OGggggish/tt-ota-sky130/sim/tb_pex_ffm40.spice

* tb_pex_ffm40 - loop gain, C-extracted DUT, ff -40C, 100u/100p
.lib /foss/pdks/sky130A/libs.tech/ngspice/sky130.lib.spice ff
.include /foss/designs/ldo_project/layout/ldo_pex_brk.spice

Vdd  vdd 0 1.8
Ib   vdd vbias 10u
Vref vref 0 0.9
Vlen load_en 0 0
X1 vref vbias vldo load_en vdd 0 fbtop_x ldo_pex_brk
CL  vldo 0 100p
IL  vldo 0 100u
L3  vldo fbtop_x 1G
Cinj fbtop_x nin 1G
Vin nin 0 0 ac 1

.nodeset v(vldo)=1.5 v(fbtop_x)=1.5
.option rshunt=1e12
.temp -40
.op
.ac dec 20 1 1G

.control
run
setplot ac1
let t    = v(vldo)/v(fbtop_x)
let t_db = db(t)
let t_ph = 180/pi*cph(t)
meas ac t0    find t_db at=1
meas ac fu    when t_db=0 cross=1
meas ac ph_fu find t_ph when t_db=0 cross=1
meas ac floor find t_db at=800meg
set hcopydevtype=svg
set color0=white
set color1=black
set svg_intopts = ( 1024 768 18 0 1 2 0 )
hardcopy bode_pex_ffm40_100u.svg t_db t_ph xlimit 1 100meg ylimit -200 200
.endc
.end
