OGggggish/tt-ota-sky130/sim/ldo_pex_brk.spice

.subckt ldo_pex_brk ua[0] ua[1] ua[2] ui_in[0] VDPWR VGND fbtop_x
* NGSPICE file created from tt_um_ogggggish_ota_ldo.ext - technology: sky130A

X0 ldo_chip_0/Msw/D4 ua[2] VGND sky130_fd_pr__res_high_po_1p41 l=1.36
X1 ldo_chip_0/Msw/D4 ui_in[0] VGND VGND sky130_fd_pr__nfet_01v8 ad=0.725 pd=5.29 as=0.725 ps=5.29 w=5 l=0.5
X2 VGND ui_in[0] ldo_chip_0/Msw/D4 VGND sky130_fd_pr__nfet_01v8 ad=0.725 pd=5.29 as=0.725 ps=5.29 w=5 l=0.5
X3 VGND ui_in[0] ldo_chip_0/Msw/D4 VGND sky130_fd_pr__nfet_01v8 ad=0.725 pd=5.29 as=1.45 ps=10.58 w=5 l=0.5
X4 ldo_chip_0/Msw/D4 ui_in[0] VGND VGND sky130_fd_pr__nfet_01v8 ad=0.725 pd=5.29 as=0.725 ps=5.29 w=5 l=0.5
X5 ldo_chip_0/Msw/D4 ui_in[0] VGND VGND sky130_fd_pr__nfet_01v8 ad=1.45 pd=10.58 as=0.725 ps=5.29 w=5 l=0.5
X6 VGND ui_in[0] ldo_chip_0/Msw/D4 VGND sky130_fd_pr__nfet_01v8 ad=0.725 pd=5.29 as=0.725 ps=5.29 w=5 l=0.5
X7 ldo_chip_0/M4/G ua[0] ldo_chip_0/M5/D VGND sky130_fd_pr__nfet_01v8 ad=1.45 pd=10.58 as=0.725 ps=5.29 w=5 l=0.5
X8 ldo_chip_0/M5/D ua[0] ldo_chip_0/M4/G VGND sky130_fd_pr__nfet_01v8 ad=0.725 pd=5.29 as=1.45 ps=10.58 w=5 l=0.5
X9 ldo_chip_0/RZ/R1 ldo_chip_0/RZ/R2 VGND sky130_fd_pr__res_high_po_0p69 l=1.2
X10 ldo_chip_0/M4/D ldo_chip_0/M2/G1 ldo_chip_0/M5/D VGND sky130_fd_pr__nfet_01v8 ad=2.9 pd=21.16 as=4.35 ps=31.74 w=5 l=0.5
X11 ldo_chip_0/M5/D ldo_chip_0/M2/G1 ldo_chip_0/M4/D VGND sky130_fd_pr__nfet_01v8 ad=0 pd=0 as=0 ps=0 w=5 l=0.5
X12 VDPWR ldo_chip_0/M4/G ldo_chip_0/M4/G VDPWR sky130_fd_pr__pfet_01v8 ad=1.45 pd=10.58 as=1.45 ps=10.58 w=5 l=0.5
X13 VDPWR ldo_chip_0/M4/G ldo_chip_0/M4/D VDPWR sky130_fd_pr__pfet_01v8 ad=382.20001 pd=2.51288k as=1.45 ps=10.58 w=5 l=0.5
X14 VGND ua[1] ldo_chip_0/M5/D VGND sky130_fd_pr__nfet_01v8 ad=1.45 pd=10.58 as=1.45 ps=10.58 w=5 l=1
X15 VGND ua[1] ua[1] VGND sky130_fd_pr__nfet_01v8 ad=29 pd=211.60001 as=1.45 ps=10.58 w=5 l=1
X16 ldo_chip_0/RZ/R2 ldo_chip_0/M4/D VDPWR VDPWR sky130_fd_pr__pfet_01v8 ad=0.725 pd=5.29 as=0.725 ps=5.29 w=5 l=0.5
X17 ldo_chip_0/RZ/R2 ldo_chip_0/M4/D VDPWR VDPWR sky130_fd_pr__pfet_01v8 ad=1.45 pd=10.58 as=0.725 ps=5.29 w=5 l=0.5
X18 VDPWR ldo_chip_0/M4/D ldo_chip_0/RZ/R2 VDPWR sky130_fd_pr__pfet_01v8 ad=0.725 pd=5.29 as=0.725 ps=5.29 w=5 l=0.5
X19 VDPWR ldo_chip_0/M4/D ldo_chip_0/RZ/R2 VDPWR sky130_fd_pr__pfet_01v8 ad=0.725 pd=5.29 as=0.725 ps=5.29 w=5 l=0.5
X20 ldo_chip_0/RZ/R2 ldo_chip_0/M4/D VDPWR VDPWR sky130_fd_pr__pfet_01v8 ad=0.725 pd=5.29 as=0.725 ps=5.29 w=5 l=0.5
X21 ldo_chip_0/RZ/R2 ldo_chip_0/M4/D VDPWR VDPWR sky130_fd_pr__pfet_01v8 ad=0.725 pd=5.29 as=0.725 ps=5.29 w=5 l=0.5
X22 VDPWR ldo_chip_0/M4/D ldo_chip_0/RZ/R2 VDPWR sky130_fd_pr__pfet_01v8 ad=0.725 pd=5.29 as=0.725 ps=5.29 w=5 l=0.5
X23 VDPWR ldo_chip_0/M4/D ldo_chip_0/RZ/R2 VDPWR sky130_fd_pr__pfet_01v8 ad=0.725 pd=5.29 as=0.725 ps=5.29 w=5 l=0.5
X24 VDPWR ldo_chip_0/M4/D ldo_chip_0/RZ/R2 VDPWR sky130_fd_pr__pfet_01v8 ad=0.725 pd=5.29 as=0.725 ps=5.29 w=5 l=0.5
X25 ldo_chip_0/RZ/R2 ldo_chip_0/M4/D VDPWR VDPWR sky130_fd_pr__pfet_01v8 ad=0.725 pd=5.29 as=0.725 ps=5.29 w=5 l=0.5
X26 ldo_chip_0/RZ/R2 ldo_chip_0/M4/D VDPWR VDPWR sky130_fd_pr__pfet_01v8 ad=0.725 pd=5.29 as=0.725 ps=5.29 w=5 l=0.5
X27 VDPWR ldo_chip_0/M4/D ldo_chip_0/RZ/R2 VDPWR sky130_fd_pr__pfet_01v8 ad=0.725 pd=5.29 as=1.45 ps=10.58 w=5 l=0.5
X28 VGND ua[1] ldo_chip_0/RZ/R2 VGND sky130_fd_pr__nfet_01v8 ad=0.725 pd=5.29 as=0.725 ps=5.29 w=5 l=1
X29 ldo_chip_0/RZ/R2 ua[1] VGND VGND sky130_fd_pr__nfet_01v8 ad=1.45 pd=10.58 as=0.725 ps=5.29 w=5 l=1
X30 VGND ua[1] ldo_chip_0/RZ/R2 VGND sky130_fd_pr__nfet_01v8 ad=0.725 pd=5.29 as=0.725 ps=5.29 w=5 l=1
X31 ldo_chip_0/RZ/R2 ua[1] VGND VGND sky130_fd_pr__nfet_01v8 ad=0.725 pd=5.29 as=0.725 ps=5.29 w=5 l=1
X32 VGND ua[1] ldo_chip_0/RZ/R2 VGND sky130_fd_pr__nfet_01v8 ad=0.725 pd=5.29 as=1.45 ps=10.58 w=5 l=1
X33 ldo_chip_0/RZ/R2 ua[1] VGND VGND sky130_fd_pr__nfet_01v8 ad=0.725 pd=5.29 as=0.725 ps=5.29 w=5 l=1
X34 VGND ua[2] VGND sky130_fd_pr__res_high_po_2p85 l=12.3
X35 ldo_chip_0/Mb1/B ldo_chip_0/RZ/R2 ldo_chip_0/Mb3/D ldo_chip_0/Mb1/B sky130_fd_pr__pfet_01v8_lvt ad=0.725 pd=5.29 as=1.45 ps=10.58 w=5 l=0.5
X36 ldo_chip_0/Mb3/D ldo_chip_0/RZ/R2 ldo_chip_0/Mb1/B ldo_chip_0/Mb1/B sky130_fd_pr__pfet_01v8_lvt ad=0.725 pd=5.29 as=0.725 ps=5.29 w=5 l=0.5
X37 ldo_chip_0/Mb3/D ldo_chip_0/RZ/R2 ldo_chip_0/Mb1/B ldo_chip_0/Mb1/B sky130_fd_pr__pfet_01v8_lvt ad=1.45 pd=10.58 as=0.725 ps=5.29 w=5 l=0.5
X38 ldo_chip_0/Mb1/B ldo_chip_0/RZ/R2 ldo_chip_0/Mb3/D ldo_chip_0/Mb1/B sky130_fd_pr__pfet_01v8_lvt ad=0.725 pd=5.29 as=0.725 ps=5.29 w=5 l=0.5
X39 ldo_chip_0/Mb1/B ldo_chip_0/RZ/R2 ldo_chip_0/Mb3/D ldo_chip_0/Mb1/B sky130_fd_pr__pfet_01v8_lvt ad=0.725 pd=5.29 as=0.725 ps=5.29 w=5 l=0.5
X40 ldo_chip_0/Mb3/D ldo_chip_0/RZ/R2 ldo_chip_0/Mb1/B ldo_chip_0/Mb1/B sky130_fd_pr__pfet_01v8_lvt ad=0.725 pd=5.29 as=0.725 ps=5.29 w=5 l=0.5
X41 ldo_chip_0/Mb3/D ldo_chip_0/RZ/R2 ldo_chip_0/Mb1/B ldo_chip_0/Mb1/B sky130_fd_pr__pfet_01v8_lvt ad=0.725 pd=5.29 as=0.725 ps=5.29 w=5 l=0.5
X42 ldo_chip_0/Mb3/D ldo_chip_0/RZ/R2 ldo_chip_0/Mb1/B ldo_chip_0/Mb1/B sky130_fd_pr__pfet_01v8_lvt ad=0.725 pd=5.29 as=0.725 ps=5.29 w=5 l=0.5
X43 ldo_chip_0/Mb1/B ldo_chip_0/RZ/R2 ldo_chip_0/Mb3/D ldo_chip_0/Mb1/B sky130_fd_pr__pfet_01v8_lvt ad=0.725 pd=5.29 as=0.725 ps=5.29 w=5 l=0.5
X44 ldo_chip_0/Mb1/B ldo_chip_0/RZ/R2 ldo_chip_0/Mb3/D ldo_chip_0/Mb1/B sky130_fd_pr__pfet_01v8_lvt ad=0.725 pd=5.29 as=0.725 ps=5.29 w=5 l=0.5
X45 VGND ldo_chip_0/Mb3/D ldo_chip_0/Mb1/B VGND sky130_fd_pr__nfet_01v8 ad=0.725 pd=5.29 as=0.725 ps=5.29 w=5 l=0.5
X46 ldo_chip_0/Mb1/B ldo_chip_0/Mb3/D VGND VGND sky130_fd_pr__nfet_01v8 ad=0.725 pd=5.29 as=0.725 ps=5.29 w=5 l=0.5
X47 ldo_chip_0/Mb1/B ldo_chip_0/Mb3/D VGND VGND sky130_fd_pr__nfet_01v8 ad=0.725 pd=5.29 as=0.725 ps=5.29 w=5 l=0.5
X48 VGND ldo_chip_0/Mb3/D ldo_chip_0/Mb1/B VGND sky130_fd_pr__nfet_01v8 ad=0.725 pd=5.29 as=0.725 ps=5.29 w=5 l=0.5
X49 VGND ldo_chip_0/Mb3/D ldo_chip_0/Mb1/B VGND sky130_fd_pr__nfet_01v8 ad=0.725 pd=5.29 as=0.725 ps=5.29 w=5 l=0.5
X50 ldo_chip_0/Mb1/B ldo_chip_0/Mb3/D VGND VGND sky130_fd_pr__nfet_01v8 ad=0.725 pd=5.29 as=0.725 ps=5.29 w=5 l=0.5
X51 ldo_chip_0/Mb1/B ldo_chip_0/Mb3/D VGND VGND sky130_fd_pr__nfet_01v8 ad=0.725 pd=5.29 as=0.725 ps=5.29 w=5 l=0.5
X52 VGND ldo_chip_0/Mb3/D ldo_chip_0/Mb1/B VGND sky130_fd_pr__nfet_01v8 ad=0.725 pd=5.29 as=0.725 ps=5.29 w=5 l=0.5
X53 ldo_chip_0/Mb1/B ldo_chip_0/Mb3/D VGND VGND sky130_fd_pr__nfet_01v8 ad=0.725 pd=5.29 as=0.725 ps=5.29 w=5 l=0.5
X54 VGND ldo_chip_0/Mb3/D ldo_chip_0/Mb1/B VGND sky130_fd_pr__nfet_01v8 ad=0.725 pd=5.29 as=0.725 ps=5.29 w=5 l=0.5
X55 VGND ldo_chip_0/Mb3/D ldo_chip_0/Mb1/B VGND sky130_fd_pr__nfet_01v8 ad=0.725 pd=5.29 as=0.725 ps=5.29 w=5 l=0.5
X56 VGND ldo_chip_0/Mb3/D ldo_chip_0/Mb1/B VGND sky130_fd_pr__nfet_01v8 ad=0.725 pd=5.29 as=1.45 ps=10.58 w=5 l=0.5
X57 ldo_chip_0/Mb1/B ldo_chip_0/Mb3/D VGND VGND sky130_fd_pr__nfet_01v8 ad=1.45 pd=10.58 as=0.725 ps=5.29 w=5 l=0.5
X58 ldo_chip_0/Mb1/B ldo_chip_0/Mb3/D VGND VGND sky130_fd_pr__nfet_01v8 ad=0.725 pd=5.29 as=0.725 ps=5.29 w=5 l=0.5
X59 VGND ldo_chip_0/Mb3/D ldo_chip_0/Mb1/B VGND sky130_fd_pr__nfet_01v8 ad=0.725 pd=5.29 as=0.725 ps=5.29 w=5 l=0.5
X60 VGND ldo_chip_0/Mb3/D ldo_chip_0/Mb1/B VGND sky130_fd_pr__nfet_01v8 ad=0.725 pd=5.29 as=0.725 ps=5.29 w=5 l=0.5
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
X265 VDPWR ldo_chip_0/Mb1/B ua[2] VDPWR sky130_fd_pr__pfet_01v8 ad=0.825 pd=5.33 as=0.825 ps=5.33 w=5 l=0.15
X266 ua[2] ldo_chip_0/Mb1/B VDPWR VDPWR sky130_fd_pr__pfet_01v8 ad=0.825 pd=5.33 as=0.825 ps=5.33 w=5 l=0.15
X267 ua[2] ldo_chip_0/Mb1/B VDPWR VDPWR sky130_fd_pr__pfet_01v8 ad=0.825 pd=5.33 as=0.825 ps=5.33 w=5 l=0.15
X268 ua[2] ldo_chip_0/Mb1/B VDPWR VDPWR sky130_fd_pr__pfet_01v8 ad=1.55 pd=10.62 as=0.825 ps=5.33 w=5 l=0.15
X269 ua[2] ldo_chip_0/Mb1/B VDPWR VDPWR sky130_fd_pr__pfet_01v8 ad=0.825 pd=5.33 as=0.825 ps=5.33 w=5 l=0.15
X270 ua[2] ldo_chip_0/Mb1/B VDPWR VDPWR sky130_fd_pr__pfet_01v8 ad=0.825 pd=5.33 as=0.825 ps=5.33 w=5 l=0.15
X271 VDPWR ldo_chip_0/Mb1/B ua[2] VDPWR sky130_fd_pr__pfet_01v8 ad=0.825 pd=5.33 as=0.825 ps=5.33 w=5 l=0.15
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
