OGggggish/tt-ota-sky130/sim/tb_ref_ss125.spice

* tb_ref_tt - loop gain, schematic DUT, tt, 100u/100p
.lib /foss/pdks/sky130A/libs.tech/ngspice/sky130.lib.spice ss
.include /foss/designs/ldo_project/ldo_chip_brk.spice

Vdd  vdd 0 1.8
Ib   vdd vbias 10u
Vref vref 0 0.9
Vlen load_en 0 0
X1 vdd vbias vref vldo load_en 0 fbtop_x ldo_chip_brk
CL  vldo 0 100p
IL  vldo 0 100u
L3  vldo fbtop_x 1G
Cinj fbtop_x nin 1G
Vin nin 0 0 ac 1

.nodeset v(vldo)=1.5 v(fbtop_x)=1.5 v(x1.vfb)=0.9 v(x1.vout1)=0.70 v(x1.vout2)=0.66 v(x1.vgate)=1.06 v(x1.nx)=0.68
.temp 125
.op
.ac dec 20 1 1G

.control
run
setplot ac1
let t    = v(vldo)/v(fbtop_x)
let t_db = db(t)
let t_ph = 180/pi*cph(t)
meas ac t0    find t_db at=1
meas ac fu    when t_db=0 cross=1
meas ac ph_fu find t_ph when t_db=0 cross=1
meas ac floor find t_db at=800meg
set hcopydevtype=svg
hardcopy bode_ref_ss125_100u.svg t_db t_ph
.endc
.end
