OGggggish/tt-ota-sky130/lvs/tt_um_ogggggish_ota_ldo_lvs.spice

* NGSPICE file created from tt_um_ogggggish_ota_ldo.ext - technology: sky130A

.subckt sky130_fd_pr__res_high_po_1p41_SX68GJ R1 R2 VSUBS
X0 R1 R2 VSUBS sky130_fd_pr__res_high_po_1p41 l=1.36
.ends

.subckt sky130_fd_pr__nfet_01v8_QDCVMV B D0 G0 S1 G1 D2 G2 S3 G3 D4 G4 S5 G5 a_445_n500#
X0 D2 G1 S1 B sky130_fd_pr__nfet_01v8 ad=0.725 pd=5.29 as=0.725 ps=5.29 w=5 l=0.5
X1 S5 G4 D4 B sky130_fd_pr__nfet_01v8 ad=0.725 pd=5.29 as=0.725 ps=5.29 w=5 l=0.5
X2 S1 G0 D0 B sky130_fd_pr__nfet_01v8 ad=0.725 pd=5.29 as=1.45 ps=10.58 w=5 l=0.5
X3 D4 G3 S3 B sky130_fd_pr__nfet_01v8 ad=0.725 pd=5.29 as=0.725 ps=5.29 w=5 l=0.5
X4 a_445_n500# G5 S5 B sky130_fd_pr__nfet_01v8 ad=1.45 pd=10.58 as=0.725 ps=5.29 w=5 l=0.5
X5 S3 G2 D2 B sky130_fd_pr__nfet_01v8 ad=0.725 pd=5.29 as=0.725 ps=5.29 w=5 l=0.5
.ends

.subckt sky130_fd_pr__nfet_01v8_ZGTXRH B D0 G0 S1 G1 a_129_n500#
X0 a_129_n500# G1 S1 B sky130_fd_pr__nfet_01v8 ad=1.45 pd=10.58 as=0.725 ps=5.29 w=5 l=0.5
X1 S1 G0 D0 B sky130_fd_pr__nfet_01v8 ad=0.725 pd=5.29 as=1.45 ps=10.58 w=5 l=0.5
.ends

.subckt sky130_fd_pr__res_high_po_0p69_ZCBMAD R1 R2 VSUBS
X0 R1 R2 VSUBS sky130_fd_pr__res_high_po_0p69 l=1.2
.ends

.subckt sky130_fd_pr__pfet_01v8_276J82 B D S G
X0 S G D B sky130_fd_pr__pfet_01v8 ad=1.45 pd=10.58 as=1.45 ps=10.58 w=5 l=0.5
.ends

.subckt sky130_fd_pr__nfet_01v8_8LGU4A B D S G
X0 S G D B sky130_fd_pr__nfet_01v8 ad=1.45 pd=10.58 as=1.45 ps=10.58 w=5 l=1
.ends

.subckt sky130_fd_pr__pfet_01v8_LDZCEX B D0 G0 S1 G1 D2 G2 S3 G3 D4 G4 S5 G5 D6 G6
+ S7 G7 D8 G8 S9 G9 D10 G10 S11 G11 a_919_n500#
X0 D2 G1 S1 B sky130_fd_pr__pfet_01v8 ad=0.725 pd=5.29 as=0.725 ps=5.29 w=5 l=0.5
X1 a_919_n500# G11 S11 B sky130_fd_pr__pfet_01v8 ad=1.45 pd=10.58 as=0.725 ps=5.29 w=5 l=0.5
X2 S5 G4 D4 B sky130_fd_pr__pfet_01v8 ad=0.725 pd=5.29 as=0.725 ps=5.29 w=5 l=0.5
X3 S11 G10 D10 B sky130_fd_pr__pfet_01v8 ad=0.725 pd=5.29 as=0.725 ps=5.29 w=5 l=0.5
X4 D8 G7 S7 B sky130_fd_pr__pfet_01v8 ad=0.725 pd=5.29 as=0.725 ps=5.29 w=5 l=0.5
X5 D4 G3 S3 B sky130_fd_pr__pfet_01v8 ad=0.725 pd=5.29 as=0.725 ps=5.29 w=5 l=0.5
X6 S7 G6 D6 B sky130_fd_pr__pfet_01v8 ad=0.725 pd=5.29 as=0.725 ps=5.29 w=5 l=0.5
X7 S9 G8 D8 B sky130_fd_pr__pfet_01v8 ad=0.725 pd=5.29 as=0.725 ps=5.29 w=5 l=0.5
X8 S3 G2 D2 B sky130_fd_pr__pfet_01v8 ad=0.725 pd=5.29 as=0.725 ps=5.29 w=5 l=0.5
X9 D6 G5 S5 B sky130_fd_pr__pfet_01v8 ad=0.725 pd=5.29 as=0.725 ps=5.29 w=5 l=0.5
X10 D10 G9 S9 B sky130_fd_pr__pfet_01v8 ad=0.725 pd=5.29 as=0.725 ps=5.29 w=5 l=0.5
X11 S1 G0 D0 B sky130_fd_pr__pfet_01v8 ad=0.725 pd=5.29 as=1.45 ps=10.58 w=5 l=0.5
.ends

.subckt sky130_fd_pr__nfet_01v8_ZCCW7F B D0 G0 S1 G1 D2 G2 S3 G3 D4 G4 S5 G5 a_745_n500#
X0 S5 G4 D4 B sky130_fd_pr__nfet_01v8 ad=0.725 pd=5.29 as=0.725 ps=5.29 w=5 l=1
X1 a_745_n500# G5 S5 B sky130_fd_pr__nfet_01v8 ad=1.45 pd=10.58 as=0.725 ps=5.29 w=5 l=1
X2 S3 G2 D2 B sky130_fd_pr__nfet_01v8 ad=0.725 pd=5.29 as=0.725 ps=5.29 w=5 l=1
X3 D4 G3 S3 B sky130_fd_pr__nfet_01v8 ad=0.725 pd=5.29 as=0.725 ps=5.29 w=5 l=1
X4 S1 G0 D0 B sky130_fd_pr__nfet_01v8 ad=0.725 pd=5.29 as=1.45 ps=10.58 w=5 l=1
X5 D2 G1 S1 B sky130_fd_pr__nfet_01v8 ad=0.725 pd=5.29 as=0.725 ps=5.29 w=5 l=1
.ends

.subckt sky130_fd_pr__res_high_po_2p85_P2GN5F R1 R2 VSUBS
X0 R1 R2 VSUBS sky130_fd_pr__res_high_po_2p85 l=12.3
.ends

.subckt sky130_fd_pr__pfet_01v8_lvt_7DKP2E B D0 G0 S1 G1 D2 G2 S3 G3 D4 G4 S5 G5 D6
+ G6 S7 G7 D8 G8 S9 G9 a_761_n500#
X0 S1 G0 D0 B sky130_fd_pr__pfet_01v8_lvt ad=0.725 pd=5.29 as=1.45 ps=10.58 w=5 l=0.5
X1 D4 G3 S3 B sky130_fd_pr__pfet_01v8_lvt ad=0.725 pd=5.29 as=0.725 ps=5.29 w=5 l=0.5
X2 a_761_n500# G9 S9 B sky130_fd_pr__pfet_01v8_lvt ad=1.45 pd=10.58 as=0.725 ps=5.29 w=5 l=0.5
X3 S7 G6 D6 B sky130_fd_pr__pfet_01v8_lvt ad=0.725 pd=5.29 as=0.725 ps=5.29 w=5 l=0.5
X4 S3 G2 D2 B sky130_fd_pr__pfet_01v8_lvt ad=0.725 pd=5.29 as=0.725 ps=5.29 w=5 l=0.5
X5 D6 G5 S5 B sky130_fd_pr__pfet_01v8_lvt ad=0.725 pd=5.29 as=0.725 ps=5.29 w=5 l=0.5
X6 D8 G7 S7 B sky130_fd_pr__pfet_01v8_lvt ad=0.725 pd=5.29 as=0.725 ps=5.29 w=5 l=0.5
X7 D2 G1 S1 B sky130_fd_pr__pfet_01v8_lvt ad=0.725 pd=5.29 as=0.725 ps=5.29 w=5 l=0.5
X8 S5 G4 D4 B sky130_fd_pr__pfet_01v8_lvt ad=0.725 pd=5.29 as=0.725 ps=5.29 w=5 l=0.5
X9 S9 G8 D8 B sky130_fd_pr__pfet_01v8_lvt ad=0.725 pd=5.29 as=0.725 ps=5.29 w=5 l=0.5
.ends

.subckt sky130_fd_pr__nfet_01v8_MPZJD2 B D0 G0 S1 G1 D2 G2 S3 G3 D4 G4 S5 G5 D6 G6
+ S7 G7 D8 G8 S9 G9 D10 G10 S11 G11 D12 G12 S13 G13 D14 G14 S15 G15 D16 G16 S17 G17
+ D18 G18 S19 G19 a_1551_n500#
X0 S5 G4 D4 B sky130_fd_pr__nfet_01v8 ad=0.725 pd=5.29 as=0.725 ps=5.29 w=5 l=0.5
X1 D6 G5 S5 B sky130_fd_pr__nfet_01v8 ad=0.725 pd=5.29 as=0.725 ps=5.29 w=5 l=0.5
X2 D16 G15 S15 B sky130_fd_pr__nfet_01v8 ad=0.725 pd=5.29 as=0.725 ps=5.29 w=5 l=0.5
X3 S9 G8 D8 B sky130_fd_pr__nfet_01v8 ad=0.725 pd=5.29 as=0.725 ps=5.29 w=5 l=0.5
X4 S15 G14 D14 B sky130_fd_pr__nfet_01v8 ad=0.725 pd=5.29 as=0.725 ps=5.29 w=5 l=0.5
X5 D12 G11 S11 B sky130_fd_pr__nfet_01v8 ad=0.725 pd=5.29 as=0.725 ps=5.29 w=5 l=0.5
X6 D2 G1 S1 B sky130_fd_pr__nfet_01v8 ad=0.725 pd=5.29 as=0.725 ps=5.29 w=5 l=0.5
X7 S19 G18 D18 B sky130_fd_pr__nfet_01v8 ad=0.725 pd=5.29 as=0.725 ps=5.29 w=5 l=0.5
X8 D8 G7 S7 B sky130_fd_pr__nfet_01v8 ad=0.725 pd=5.29 as=0.725 ps=5.29 w=5 l=0.5
X9 S11 G10 D10 B sky130_fd_pr__nfet_01v8 ad=0.725 pd=5.29 as=0.725 ps=5.29 w=5 l=0.5
X10 S13 G12 D12 B sky130_fd_pr__nfet_01v8 ad=0.725 pd=5.29 as=0.725 ps=5.29 w=5 l=0.5
X11 S1 G0 D0 B sky130_fd_pr__nfet_01v8 ad=0.725 pd=5.29 as=1.45 ps=10.58 w=5 l=0.5
X12 a_1551_n500# G19 S19 B sky130_fd_pr__nfet_01v8 ad=1.45 pd=10.58 as=0.725 ps=5.29 w=5 l=0.5
X13 D4 G3 S3 B sky130_fd_pr__nfet_01v8 ad=0.725 pd=5.29 as=0.725 ps=5.29 w=5 l=0.5
X14 S17 G16 D16 B sky130_fd_pr__nfet_01v8 ad=0.725 pd=5.29 as=0.725 ps=5.29 w=5 l=0.5
X15 S7 G6 D6 B sky130_fd_pr__nfet_01v8 ad=0.725 pd=5.29 as=0.725 ps=5.29 w=5 l=0.5
X16 D10 G9 S9 B sky130_fd_pr__nfet_01v8 ad=0.725 pd=5.29 as=0.725 ps=5.29 w=5 l=0.5
X17 D14 G13 S13 B sky130_fd_pr__nfet_01v8 ad=0.725 pd=5.29 as=0.725 ps=5.29 w=5 l=0.5
X18 S3 G2 D2 B sky130_fd_pr__nfet_01v8 ad=0.725 pd=5.29 as=0.725 ps=5.29 w=5 l=0.5
X19 D18 G17 S17 B sky130_fd_pr__nfet_01v8 ad=0.725 pd=5.29 as=0.725 ps=5.29 w=5 l=0.5
.ends

.subckt sky130_fd_pr__nfet_01v8_C8VJM3 B D0 G0 S1 G1 a_229_n500#
X0 S1 G0 D0 B sky130_fd_pr__nfet_01v8 ad=0.725 pd=5.29 as=1.45 ps=10.58 w=5 l=1
X1 a_229_n500# G1 S1 B sky130_fd_pr__nfet_01v8 ad=1.45 pd=10.58 as=0.725 ps=5.29 w=5 l=1
.ends

.subckt sky130_fd_pr__pfet_01v8_VZYCCN B D0 G0 S1 G1 D2 G2 S3 G3 D4 S4 G4
X0 D2 G1 S1 B sky130_fd_pr__pfet_01v8 ad=0.725 pd=5.29 as=0.725 ps=5.29 w=5 l=0.5
X1 D4 G3 S3 B sky130_fd_pr__pfet_01v8 ad=0.725 pd=5.29 as=0.725 ps=5.29 w=5 l=0.5
X2 S1 G0 D0 B sky130_fd_pr__pfet_01v8 ad=0.725 pd=5.29 as=1.45 ps=10.58 w=5 l=0.5
X3 S4 G4 D4 B sky130_fd_pr__pfet_01v8 ad=1.45 pd=10.58 as=0.725 ps=5.29 w=5 l=0.5
X4 S3 G2 D2 B sky130_fd_pr__pfet_01v8 ad=0.725 pd=5.29 as=0.725 ps=5.29 w=5 l=0.5
.ends

.subckt sky130_fd_pr__cap_mim_m3_1_K7QY89 C2_0 C1_0 C2_1 C1_1 C2_2 C1_2 C2_3 C1_3
+ C2_4 C1_4
X0 C1_1 C2_1 sky130_fd_pr__cap_mim_m3_1 l=25 w=20
X1 C1_3 C2_3 sky130_fd_pr__cap_mim_m3_1 l=25 w=20
X2 C1_1 C2_1 sky130_fd_pr__cap_mim_m3_1 l=25 w=20
X3 C1_2 C2_2 sky130_fd_pr__cap_mim_m3_1 l=25 w=20
X4 C1_2 C2_2 sky130_fd_pr__cap_mim_m3_1 l=25 w=20
X5 C1_2 C2_2 sky130_fd_pr__cap_mim_m3_1 l=25 w=20
X6 C1_0 C2_0 sky130_fd_pr__cap_mim_m3_1 l=25 w=20
X7 C1_3 C2_3 sky130_fd_pr__cap_mim_m3_1 l=25 w=20
X8 C1_3 C2_3 sky130_fd_pr__cap_mim_m3_1 l=25 w=20
X9 C1_3 C2_3 sky130_fd_pr__cap_mim_m3_1 l=25 w=20
X10 C1_2 C2_2 sky130_fd_pr__cap_mim_m3_1 l=25 w=20
X11 C1_4 C2_4 sky130_fd_pr__cap_mim_m3_1 l=25 w=20
X12 C1_1 C2_1 sky130_fd_pr__cap_mim_m3_1 l=25 w=20
X13 C1_4 C2_4 sky130_fd_pr__cap_mim_m3_1 l=25 w=20
X14 C1_4 C2_4 sky130_fd_pr__cap_mim_m3_1 l=25 w=20
X15 C1_0 C2_0 sky130_fd_pr__cap_mim_m3_1 l=25 w=20
X16 C1_0 C2_0 sky130_fd_pr__cap_mim_m3_1 l=25 w=20
X17 C1_0 C2_0 sky130_fd_pr__cap_mim_m3_1 l=25 w=20
X18 C1_1 C2_1 sky130_fd_pr__cap_mim_m3_1 l=25 w=20
X19 C1_4 C2_4 sky130_fd_pr__cap_mim_m3_1 l=25 w=20
.ends

.subckt sky130_fd_pr__pfet_01v8_2L9K8S B D0 G0 S1 G1 D2 G2 S3 G3 D4 G4 S5 G5 D6 G6
+ S7 G7 D8 G8 S9 G9 D10 G10 S11 G11 D12 G12 S13 G13 D14 G14 S15 G15 D16 G16 S17 G17
+ D18 G18 S19 G19 D20 G20 S21 G21 D22 G22 S23 G23 D24 G24 S25 G25 D26 G26 S27 G27
+ D28 G28 S29 G29 D30 G30 S31 G31 D32 G32 S33 G33 D34 G34 S35 G35 D36 G36 S37 G37
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
X47 D2 G1 S1 B sky130_fd_pr__pfet_01v8 ad=0.725 pd=5.29 as=0.725 ps=5.29 w=5 l=0.5
X48 S49 G48 D48 B sky130_fd_pr__pfet_01v8 ad=0.725 pd=5.29 as=0.725 ps=5.29 w=5 l=0.5
X49 D20 G19 S19 B sky130_fd_pr__pfet_01v8 ad=0.725 pd=5.29 as=0.725 ps=5.29 w=5 l=0.5
.ends

.subckt sky130_fd_pr__cap_mim_m3_1_G88Z52 C2 C1
X0 C1 C2 sky130_fd_pr__cap_mim_m3_1 l=25 w=20
X1 C1 C2 sky130_fd_pr__cap_mim_m3_1 l=25 w=20
.ends

.subckt sky130_fd_pr__res_xhigh_po_0p35_R2G5RU R1 R2 VSUBS
X0 R1 R2 VSUBS sky130_fd_pr__res_xhigh_po_0p35 l=35
.ends

.subckt sky130_fd_pr__res_xhigh_po_0p35_S5EEZV R1 R2 VSUBS
X0 R1 R2 VSUBS sky130_fd_pr__res_xhigh_po_0p35 l=52.5
.ends

.subckt sky130_fd_pr__pfet_01v8_Z5EYDS B D0_0 G0_0 D0_1 G0_1 D0_2 G0_2 D0_3 G0_3 D0_4
+ G0_4 S1_0 G1_0 S1_1 G1_1 S1_2 G1_2 S1_3 G1_3 S1_4 G1_4 D2_0 G2_0 D2_1 G2_1 D2_2
+ G2_2 D2_3 G2_3 D2_4 G2_4 S3_0 G3_0 S3_1 G3_1 S3_2 G3_2 S3_3 G3_3 S3_4 G3_4 D4_0
+ G4_0 D4_1 G4_1 D4_2 G4_2 D4_3 G4_3 D4_4 G4_4 S5_0 G5_0 S5_1 G5_1 S5_2 G5_2 S5_3
+ G5_3 S5_4 G5_4 D6_0 G6_0 D6_1 G6_1 D6_2 G6_2 D6_3 G6_3 D6_4 G6_4 S7_0 G7_0 S7_1
+ G7_1 S7_2 G7_2 S7_3 G7_3 S7_4 G7_4 D8_0 G8_0 D8_1 G8_1 D8_2 G8_2 D8_3 G8_3 D8_4
+ G8_4 S9_0 G9_0 S9_1 G9_1 S9_2 G9_2 S9_3 G9_3 S9_4 G9_4 D10_0 G10_0 D10_1 G10_1 D10_2
+ G10_2 D10_3 G10_3 D10_4 G10_4 S11_0 G11_0 S11_1 G11_1 S11_2 G11_2 S11_3 G11_3 S11_4
+ G11_4 D12_0 G12_0 D12_1 G12_1 D12_2 G12_2 D12_3 G12_3 D12_4 G12_4 S13_0 G13_0 S13_1
+ G13_1 S13_2 G13_2 S13_3 G13_3 S13_4 G13_4 D14_0 G14_0 D14_1 G14_1 D14_2 G14_2 D14_3
+ G14_3 D14_4 G14_4 S15_0 G15_0 S15_1 G15_1 S15_2 G15_2 S15_3 G15_3 S15_4 G15_4 D16_0
+ G16_0 D16_1 G16_1 D16_2 G16_2 D16_3 G16_3 D16_4 G16_4 S17_0 G17_0 S17_1 G17_1 S17_2
+ G17_2 S17_3 G17_3 S17_4 G17_4 D18_0 G18_0 D18_1 G18_1 D18_2 G18_2 D18_3 G18_3 D18_4
+ G18_4 S19_0 G19_0 S19_1 G19_1 S19_2 G19_2 S19_3 G19_3 S19_4 G19_4 D20_0 G20_0 D20_1
+ G20_1 D20_2 G20_2 D20_3 G20_3 D20_4 G20_4 S21_0 G21_0 S21_1 G21_1 S21_2 G21_2 S21_3
+ G21_3 S21_4 G21_4 D22_0 G22_0 D22_1 G22_1 D22_2 G22_2 D22_3 G22_3 D22_4 G22_4 S23_0
+ G23_0 S23_1 G23_1 S23_2 G23_2 S23_3 G23_3 S23_4 G23_4 D24_0 G24_0 D24_1 G24_1 D24_2
+ G24_2 D24_3 G24_3 D24_4 G24_4 S25_0 G25_0 S25_1 G25_1 S25_2 G25_2 S25_3 G25_3 S25_4
+ G25_4 D26_0 G26_0 D26_1 G26_1 D26_2 G26_2 D26_3 G26_3 D26_4 G26_4 S27_0 G27_0 S27_1
+ G27_1 S27_2 G27_2 S27_3 G27_3 S27_4 G27_4 D28_0 G28_0 D28_1 G28_1 D28_2 G28_2 D28_3
+ G28_3 D28_4 G28_4 S29_0 G29_0 S29_1 G29_1 S29_2 G29_2 S29_3 G29_3 S29_4 G29_4 D30_0
+ G30_0 D30_1 G30_1 D30_2 G30_2 D30_3 G30_3 D30_4 G30_4 S31_0 G31_0 S31_1 G31_1 S31_2
+ G31_2 S31_3 G31_3 S31_4 G31_4 D32_0 G32_0 D32_1 G32_1 D32_2 G32_2 D32_3 G32_3 D32_4
+ G32_4 S33_0 G33_0 S33_1 G33_1 S33_2 G33_2 S33_3 G33_3 S33_4 G33_4 D34_0 G34_0 D34_1
+ G34_1 D34_2 G34_2 D34_3 G34_3 D34_4 G34_4 S35_0 G35_0 S35_1 G35_1 S35_2 G35_2 S35_3
+ G35_3 S35_4 G35_4 D36_0 G36_0 D36_1 G36_1 D36_2 G36_2 D36_3 G36_3 D36_4 G36_4 S37_0
+ G37_0 S37_1 G37_1 S37_2 G37_2 S37_3 G37_3 S37_4 G37_4 D38_0 G38_0 D38_1 G38_1 D38_2
+ G38_2 D38_3 G38_3 D38_4 G38_4 S39_0 G39_0 S39_1 G39_1 S39_2 G39_2 S39_3 G39_3 S39_4
+ G39_4 D40_0 G40_0 D40_1 G40_1 D40_2 G40_2 D40_3 G40_3 D40_4 G40_4 S41_0 G41_0 S41_1
+ G41_1 S41_2 G41_2 S41_3 G41_3 S41_4 G41_4 D42_0 G42_0 D42_1 G42_1 D42_2 G42_2 D42_3
+ G42_3 D42_4 G42_4 S43_0 G43_0 S43_1 G43_1 S43_2 G43_2 S43_3 G43_3 S43_4 G43_4 D44_0
+ G44_0 D44_1 G44_1 D44_2 G44_2 D44_3 G44_3 D44_4 G44_4 S45_0 G45_0 S45_1 G45_1 S45_2
+ G45_2 S45_3 G45_3 S45_4 G45_4 D46_0 G46_0 D46_1 G46_1 D46_2 G46_2 D46_3 G46_3 D46_4
+ G46_4 S47_0 G47_0 S47_1 G47_1 S47_2 G47_2 S47_3 G47_3 S47_4 G47_4 D48_0 G48_0 D48_1
+ G48_1 D48_2 G48_2 D48_3 G48_3 D48_4 G48_4 S49_0 G49_0 S49_1 G49_1 S49_2 G49_2 S49_3
+ G49_3 S49_4 G49_4 D50_0 G50_0 D50_1 G50_1 D50_2 G50_2 D50_3 G50_3 D50_4 G50_4 S51_0
+ G51_0 S51_1 G51_1 S51_2 G51_2 S51_3 G51_3 S51_4 G51_4 D52_0 G52_0 D52_1 G52_1 D52_2
+ G52_2 D52_3 G52_3 D52_4 G52_4 S53_0 G53_0 S53_1 G53_1 S53_2 G53_2 S53_3 G53_3 S53_4
+ G53_4 D54_0 G54_0 D54_1 G54_1 D54_2 G54_2 D54_3 G54_3 D54_4 G54_4 S55_0 G55_0 S55_1
+ G55_1 S55_2 G55_2 S55_3 G55_3 S55_4 G55_4 D56_0 G56_0 D56_1 G56_1 D56_2 G56_2 D56_3
+ G56_3 D56_4 G56_4 S57_0 G57_0 S57_1 G57_1 S57_2 G57_2 S57_3 G57_3 S57_4 G57_4 D58_0
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
X0 S23_1 G22_1 D22_1 B sky130_fd_pr__pfet_01v8 ad=0.825 pd=5.33 as=0.825 ps=5.33 w=5 l=0.15
X1 S53_0 G52_0 D52_0 B sky130_fd_pr__pfet_01v8 ad=0.825 pd=5.33 as=0.825 ps=5.33 w=5 l=0.15
X2 D2_1 G1_1 S1_1 B sky130_fd_pr__pfet_01v8 ad=0.825 pd=5.33 as=0.825 ps=5.33 w=5 l=0.15
X3 D74_0 G73_0 S73_0 B sky130_fd_pr__pfet_01v8 ad=0.825 pd=5.33 as=0.825 ps=5.33 w=5 l=0.15
X4 D16_2 G15_2 S15_2 B sky130_fd_pr__pfet_01v8 ad=0.825 pd=5.33 as=0.825 ps=5.33 w=5 l=0.15
X5 S73_4 G72_4 D72_4 B sky130_fd_pr__pfet_01v8 ad=0.825 pd=5.33 as=0.825 ps=5.33 w=5 l=0.15
X6 S75_2 G74_2 D74_2 B sky130_fd_pr__pfet_01v8 ad=0.825 pd=5.33 as=0.825 ps=5.33 w=5 l=0.15
X7 D52_4 G51_4 S51_4 B sky130_fd_pr__pfet_01v8 ad=0.825 pd=5.33 as=0.825 ps=5.33 w=5 l=0.15
X8 S17_1 G16_1 D16_1 B sky130_fd_pr__pfet_01v8 ad=0.825 pd=5.33 as=0.825 ps=5.33 w=5 l=0.15
X9 S75_0 G74_0 D74_0 B sky130_fd_pr__pfet_01v8 ad=0.825 pd=5.33 as=0.825 ps=5.33 w=5 l=0.15
X10 D38_0 G37_0 S37_0 B sky130_fd_pr__pfet_01v8 ad=0.825 pd=5.33 as=0.825 ps=5.33 w=5 l=0.15
X11 D54_2 G53_2 S53_2 B sky130_fd_pr__pfet_01v8 ad=0.825 pd=5.33 as=0.825 ps=5.33 w=5 l=0.15
X12 S9_2 G8_2 D8_2 B sky130_fd_pr__pfet_01v8 ad=0.825 pd=5.33 as=0.825 ps=5.33 w=5 l=0.15
X13 D42_4 G41_4 S41_4 B sky130_fd_pr__pfet_01v8 ad=0.825 pd=5.33 as=0.825 ps=5.33 w=5 l=0.15
X14 D72_1 G71_1 S71_1 B sky130_fd_pr__pfet_01v8 ad=0.825 pd=5.33 as=0.825 ps=5.33 w=5 l=0.15
X15 D58_0 G57_0 S57_0 B sky130_fd_pr__pfet_01v8 ad=0.825 pd=5.33 as=0.825 ps=5.33 w=5 l=0.15
X16 D46_0 G45_0 S45_0 B sky130_fd_pr__pfet_01v8 ad=0.825 pd=5.33 as=0.825 ps=5.33 w=5 l=0.15
X17 S17_3 G16_3 D16_3 B sky130_fd_pr__pfet_01v8 ad=0.825 pd=5.33 as=0.825 ps=5.33 w=5 l=0.15
X18 S17_4 G16_4 D16_4 B sky130_fd_pr__pfet_01v8 ad=0.825 pd=5.33 as=0.825 ps=5.33 w=5 l=0.15
X19 D70_2 G69_2 S69_2 B sky130_fd_pr__pfet_01v8 ad=0.825 pd=5.33 as=0.825 ps=5.33 w=5 l=0.15
X20 D44_2 G43_2 S43_2 B sky130_fd_pr__pfet_01v8 ad=0.825 pd=5.33 as=0.825 ps=5.33 w=5 l=0.15
X21 D40_2 G39_2 S39_2 B sky130_fd_pr__pfet_01v8 ad=0.825 pd=5.33 as=0.825 ps=5.33 w=5 l=0.15
X22 D30_2 G29_2 S29_2 B sky130_fd_pr__pfet_01v8 ad=0.825 pd=5.33 as=0.825 ps=5.33 w=5 l=0.15
X23 S1_4 G0_4 D0_4 B sky130_fd_pr__pfet_01v8 ad=0.825 pd=5.33 as=1.55 ps=10.62 w=5 l=0.15
X24 D18_3 G17_3 S17_3 B sky130_fd_pr__pfet_01v8 ad=0.825 pd=5.33 as=0.825 ps=5.33 w=5 l=0.15
X25 S15_3 G14_3 D14_3 B sky130_fd_pr__pfet_01v8 ad=0.825 pd=5.33 as=0.825 ps=5.33 w=5 l=0.15
X26 D12_3 G11_3 S11_3 B sky130_fd_pr__pfet_01v8 ad=0.825 pd=5.33 as=0.825 ps=5.33 w=5 l=0.15
X27 D12_1 G11_1 S11_1 B sky130_fd_pr__pfet_01v8 ad=0.825 pd=5.33 as=0.825 ps=5.33 w=5 l=0.15
X28 D64_0 G63_0 S63_0 B sky130_fd_pr__pfet_01v8 ad=0.825 pd=5.33 as=0.825 ps=5.33 w=5 l=0.15
X29 a_3807_n2972# G79_0 S79_0 B sky130_fd_pr__pfet_01v8 ad=1.55 pd=10.62 as=0.825 ps=5.33 w=5 l=0.15
X30 S33_0 G32_0 D32_0 B sky130_fd_pr__pfet_01v8 ad=0.825 pd=5.33 as=0.825 ps=5.33 w=5 l=0.15
X31 S19_3 G18_3 D18_3 B sky130_fd_pr__pfet_01v8 ad=0.825 pd=5.33 as=0.825 ps=5.33 w=5 l=0.15
X32 D20_2 G19_2 S19_2 B sky130_fd_pr__pfet_01v8 ad=0.825 pd=5.33 as=0.825 ps=5.33 w=5 l=0.15
X33 D16_3 G15_3 S15_3 B sky130_fd_pr__pfet_01v8 ad=0.825 pd=5.33 as=0.825 ps=5.33 w=5 l=0.15
X34 S13_3 G12_3 D12_3 B sky130_fd_pr__pfet_01v8 ad=0.825 pd=5.33 as=0.825 ps=5.33 w=5 l=0.15
X35 D10_3 G9_3 S9_3 B sky130_fd_pr__pfet_01v8 ad=0.825 pd=5.33 as=0.825 ps=5.33 w=5 l=0.15
X36 D28_0 G27_0 S27_0 B sky130_fd_pr__pfet_01v8 ad=0.825 pd=5.33 as=0.825 ps=5.33 w=5 l=0.15
X37 S69_4 G68_4 D68_4 B sky130_fd_pr__pfet_01v8 ad=0.825 pd=5.33 as=0.825 ps=5.33 w=5 l=0.15
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
X115 D46_1 G45_1 S45_1 B sky130_fd_pr__pfet_01v8 ad=0.825 pd=5.33 as=0.825 ps=5.33 w=5 l=0.15
X116 D10_0 G9_0 S9_0 B sky130_fd_pr__pfet_01v8 ad=0.825 pd=5.33 as=0.825 ps=5.33 w=5 l=0.15
X117 S21_2 G20_2 D20_2 B sky130_fd_pr__pfet_01v8 ad=0.825 pd=5.33 as=0.825 ps=5.33 w=5 l=0.15
X118 S23_3 G22_3 D22_3 B sky130_fd_pr__pfet_01v8 ad=0.825 pd=5.33 as=0.825 ps=5.33 w=5 l=0.15
X119 D20_3 G19_3 S19_3 B sky130_fd_pr__pfet_01v8 ad=0.825 pd=5.33 as=0.825 ps=5.33 w=5 l=0.15
X120 D68_4 G67_4 S67_4 B sky130_fd_pr__pfet_01v8 ad=0.825 pd=5.33 as=0.825 ps=5.33 w=5 l=0.15
X121 a_3807_n1736# G79_1 S79_1 B sky130_fd_pr__pfet_01v8 ad=1.55 pd=10.62 as=0.825 ps=5.33 w=5 l=0.15
X122 D64_1 G63_1 S63_1 B sky130_fd_pr__pfet_01v8 ad=0.825 pd=5.33 as=0.825 ps=5.33 w=5 l=0.15
X123 D54_3 G53_3 S53_3 B sky130_fd_pr__pfet_01v8 ad=0.825 pd=5.33 as=0.825 ps=5.33 w=5 l=0.15
X124 S39_4 G38_4 D38_4 B sky130_fd_pr__pfet_01v8 ad=0.825 pd=5.33 as=0.825 ps=5.33 w=5 l=0.15
X125 D24_3 G23_3 S23_3 B sky130_fd_pr__pfet_01v8 ad=0.825 pd=5.33 as=0.825 ps=5.33 w=5 l=0.15
X126 S33_1 G32_1 D32_1 B sky130_fd_pr__pfet_01v8 ad=0.825 pd=5.33 as=0.825 ps=5.33 w=5 l=0.15
X127 S21_3 G20_3 D20_3 B sky130_fd_pr__pfet_01v8 ad=0.825 pd=5.33 as=0.825 ps=5.33 w=5 l=0.15
X128 S37_2 G36_2 D36_2 B sky130_fd_pr__pfet_01v8 ad=0.825 pd=5.33 as=0.825 ps=5.33 w=5 l=0.15
X129 D28_1 G27_1 S27_1 B sky130_fd_pr__pfet_01v8 ad=0.825 pd=5.33 as=0.825 ps=5.33 w=5 l=0.15
X130 D14_2 G13_2 S13_2 B sky130_fd_pr__pfet_01v8 ad=0.825 pd=5.33 as=0.825 ps=5.33 w=5 l=0.15
X131 S53_3 G52_3 D52_3 B sky130_fd_pr__pfet_01v8 ad=0.825 pd=5.33 as=0.825 ps=5.33 w=5 l=0.15
X132 D56_3 G55_3 S55_3 B sky130_fd_pr__pfet_01v8 ad=0.825 pd=5.33 as=0.825 ps=5.33 w=5 l=0.15
X133 S59_3 G58_3 D58_3 B sky130_fd_pr__pfet_01v8 ad=0.825 pd=5.33 as=0.825 ps=5.33 w=5 l=0.15
X134 S77_2 G76_2 D76_2 B sky130_fd_pr__pfet_01v8 ad=0.825 pd=5.33 as=0.825 ps=5.33 w=5 l=0.15
X135 D22_4 G21_4 S21_4 B sky130_fd_pr__pfet_01v8 ad=0.825 pd=5.33 as=0.825 ps=5.33 w=5 l=0.15
X136 D52_3 G51_3 S51_3 B sky130_fd_pr__pfet_01v8 ad=0.825 pd=5.33 as=0.825 ps=5.33 w=5 l=0.15
X137 D58_3 G57_3 S57_3 B sky130_fd_pr__pfet_01v8 ad=0.825 pd=5.33 as=0.825 ps=5.33 w=5 l=0.15
X138 S55_3 G54_3 D54_3 B sky130_fd_pr__pfet_01v8 ad=0.825 pd=5.33 as=0.825 ps=5.33 w=5 l=0.15
X139 S61_3 G60_3 D60_3 B sky130_fd_pr__pfet_01v8 ad=0.825 pd=5.33 as=0.825 ps=5.33 w=5 l=0.15
X140 S69_1 G68_1 D68_1 B sky130_fd_pr__pfet_01v8 ad=0.825 pd=5.33 as=0.825 ps=5.33 w=5 l=0.15
X141 D20_0 G19_0 S19_0 B sky130_fd_pr__pfet_01v8 ad=0.825 pd=5.33 as=0.825 ps=5.33 w=5 l=0.15
X142 D6_1 G5_1 S5_1 B sky130_fd_pr__pfet_01v8 ad=0.825 pd=5.33 as=0.825 ps=5.33 w=5 l=0.15
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
