OGggggish/tt-ota-sky130/(commit log)

2026-07-15 D3: LDO loop closed, vldo=1.5008V, all 9 devices saturated
    [ldo_top.sch, two_stage_ota.sch]
2026-07-15 D4: loop gain measured (t0=84dB, fu=272kHz, PM~0), sustained 10MHz oscillation confirmed in tran - Miller pole and output pole coincide, Leung03 fix planned
    [ldo_top.sch]
2026-07-15 D5: compensation frozen (CM=2p RZ=10), PM 65-79deg over 3-50mA; RZ-zero and ESR-zero routes evaluated and rejected; spec set to min load 3mA
    [ldo_top.sch]
2026-07-15 D6: PSRR measured - 67-74dB @ DC-1kHz, -34dB @ 100kHz, worst -12.9dB @ 1.5MHz hump, -47dB HF floor (50mOhm ESR), load-insensitive over 3-50mA
    [ldo_top.sch]
2026-07-17 Load transient verified 3 conditions: stress 9.9mA/200ns -880mV, typ 1us -183mV, TT 3mA -263mV; recovery <2us zero-ring, gear-validated, vavg 1.50107 invariant
    [ldo_tran.sch]
2026-07-17 D10: corner verification complete (ss/125 + ff/-40 x startup/AC/op all green, worst PM 56.1deg @ss125, fu max 2.34M, circuit frozen)
2026-07-18 D11: DUT/testbench split (ldo_chip 9-pin) + PDK passives (2x cap_mim stack 22p, 4x poly res); recert all green, worst PM 55.0 @ss125, fu 2.30M, circuit frozen for layout
    [ldo_chip.sch, ldo_top.sch, ldo_tran.sch]
2026-07-18 D12: power axis complete (PSRR -64.8dB lf / +1.5dB pk @3.2M; line transient +/-20mV, plateau 20uV; line reg -0.7mV/V triple-verified; dropout 14.8mV @1.1mA tt via ramp method)
2026-07-18 move schematics to src/ (canonical dir): add ldo_chip.sch/.sym, update testbenches; root copies removed (D11 path fix)
    [ldo_chip.sch, ldo_top.sch, ldo_tran.sch]
2026-07-18 fix: schematics to canonical src/schematics/ (ldo_chip added, testbenches updated), stray copies removed
    [ldo_chip.sch, ldo_top.sch, ldo_tran.sch]
2026-07-18 Enhance pinout descriptions in info.yaml
    Updated pin descriptions for ui and ua pins.
2026-07-18 D13: on-chip bias mirrors Mb3-Mb6, ideal I1/I2 retired; recert 5/5 green (op bit-exact, PSRR -64.8/+1.44 unchanged, startup 1.50111, PM 60.7/55.1/70.6 shift <0.1deg); circuit final for layout
    [ldo_chip.sch, ldo_top.sch, ldo_tran.sch]
2026-07-19 D4: all 43 devices placed, DRC baseline 1208
2026-07-20 D5: rebin x5 + Rload 568ohm both sides; ngspice-46 re-baseline; cap buses C1/C2 two-net; DRC=0
    [ldo_chip.sch, ldo_top.sch, ldo_tran.sch]
2026-07-21 D6-D7: Mp complete (comb + VDPWR sources+body + vgate spine) + south lanes live + Rf2 grounded, DRC=0
2026-07-22 D9: OTA core complete — Miller loop closed, Z3 wired, DRC=0
2026-07-22 sch: fbtop loop closed (fbtop->vldo), vgate/nx pins -> labels
    [ldo_chip.sch]
2026-07-22 sch: fbtop loop closed, vgate/nx probe pins removed
    [ldo_chip.sch]
2026-07-23 D9 complete: OTA wired, power skeleton, vref/vldo/fbtop lines, sch 6-port
2026-07-24 D10: all nets routed — Z2 complete, zero dangling terminals
2026-07-24 D10: all nets routed + 6 port labels — zero dangling terminals
2026-07-24 D11: LVS clean - Circuits match uniquely; flip CM plate order in sch to match as-built layout; add LVS wrapper/netlist/report
    [ldo_chip.sch]
2026-07-25 D13: add GDS+LEF for TT flow; docs/info.md + README with post-layout results
2026-07-25 D13: widen rpm/urpm implant inside resistor cells (klayout post-fix, grid-snapped)
